BhagyaYasarathna/Hot-Plate-Controller-using-PID/README.md

# Hot-Plate-Controller-using-PID
This project (team) was done for EN2090-Laboratory Practice-II module under Electronic and Telecommunication Engineering degree program. 
This is an Analog PID Controller to control the temperature up to 200 degree Celcius of a hotplate.
