BhagyaYasarathna/Hot-Plate-Controller-using-PID/(list of files, drawings)

Other design files:
PowerSupply.pdsprj
